akpc806a/Voltage_Logger/Firmware/IAR/README.md

This is project for IAR 6.50.3.4757 based on ChibiOS 2.6.7 RTOS for voltage logger
