akpc806a/Voltage_Logger/Tests/Temperature/Temperature.xlsx

Sheet: 00-00-07
Timestamp | ch #1 | ch #3 | ch #5 | ch #7 |  |  | Calculted temperature | Extech SDL200 | Error
8972 | 1.669652 | 1.148777 | 0.730923 | 0.832038 | Vref | 1.24 | 85.9304 | 85.8 | -0.1304
9972 | 1.667912 | 1.173341 | 0.743655 | 0.869477 | Gain | 0.005 | 85.5824 | 85.8 | 0.2176
10972 | 1.667856 | 1.192365 | 0.774777 | 0.906898 |  |  | 85.5712 | 85 | -0.5712
11972 | 1.667979 | 1.205415 | 0.789159 | 0.917454 |  |  | 85.5958 | 85 | -0.5958
12972 | 1.668414 | 1.215902 | 0.806305 | 0.935535 |  |  | 85.6828 | 85 | -0.6828
13972 | 1.667759 | 1.223687 | 0.818528 | 0.957894 |  |  | 85.5518 | 85 | -0.5518
14972 | 1.667035 | 1.229264 | 0.834112 | 0.979133 |  |  | 85.407 | 85 | -0.407
15972 | 1.666353 | 1.232514 | 0.854215 | 0.989091 |  |  | 85.2706 | 84.9 | -0.3706
16972 | 1.666536 | 1.235038 | 0.87494 | 0.988742 |  |  | 85.3072 | 84.9 | -0.4072
17972 | 1.66641 | 1.23622 | 0.877621 | 0.985095 |  |  | 85.282 | 84.8 | -0.482
18972 | 1.666479 | 1.237693 | 0.866878 | 0.980948 |  |  | 85.2958 | 84.7 | -0.5958
19972 | 1.666222 | 1.237985 | 0.860801 | 0.978258 |  |  | 85.2444 | 84.6 | -0.6444
20972 | 1.666234 | 1.238569 | 0.858324 | 0.976886 |  |  | 85.2468 | 84.6 | -0.6468
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
