akpc806a/Voltage_Logger/Tests/AC/XLS/50Hz.xls

Timestamp | ch #1 | ch #2 | ch #3 | ch #4 | ch #5 | ch #6
1249693 | 2.823217 | 2.823291 | 2.822742 | 2.815551 | 2.799818 | 2.768135 | 2.725456 | 2.675368 | 0
1249693 | 2.828029 | 2.823327 | 2.821532 | 2.820497 | 2.80821 | 2.785501 | 2.751491 | 2.723666 | 0
1249694 | 2.819208 | 2.824634 | 2.820223 | 2.820053 | 2.815592 | 2.802511 | 2.77843 | 2.747098 | 1
1249694 | 2.822416 | 2.823371 | 2.821441 | 2.821136 | 2.819011 | 2.810856 | 2.79458 | 2.771691 | 1
1249695 | 2.824019 | 2.822134 | 2.823909 | 2.821287 | 2.820044 | 2.814165 | 2.802276 | 2.788012 | 2
1249695 | 2.825623 | 2.82238 | 2.820185 | 2.821087 | 2.820086 | 2.818016 | 2.809836 | 2.795511 | 2
1249696 | 2.82001 | 2.821805 | 2.821068 | 2.821568 | 2.819959 | 2.819995 | 2.813159 | 2.803486 | 3
1249696 | 2.820812 | 2.822239 | 2.820561 | 2.820442 | 2.820106 | 2.820467 | 2.815516 | 2.809169 | 3
1249697 | 2.820812 | 2.818284 | 2.82151 | 2.822335 | 2.820624 | 2.820868 | 2.817389 | 2.81156 | 4
1249697 | 2.820812 | 2.82038 | 2.820765 | 2.821418 | 2.819721 | 2.820692 | 2.818974 | 2.814574 | 4
1249698 | 2.819208 | 2.817951 | 2.819907 | 2.821907 | 2.820787 | 2.820261 | 2.81902 | 2.815933 | 5
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
