akpc806a/Voltage_Logger/Tests/AC/XLS/50Hz_sine.xls

Timestamp | ch #1 | ch #2 | ch #3
130326 | 1.957188 | 1.900009 | 1.834909 | 1.772586 | 1.711889 | 1.654843 | 1.669148 | 1.617489 | 0
130326 | 2.162469 | 2.105605 | 2.042101 | 1.980809 | 1.920322 | 1.861985 | 1.805135 | 1.751734 | 0
130327 | 2.284355 | 2.229644 | 2.172766 | 2.17375 | 2.115637 | 2.057524 | 2.001172 | 1.946627 | 1
130327 | 2.446334 | 2.402208 | 2.350606 | 2.292805 | 2.23642 | 2.179936 | 2.182333 | 2.127653 | 1
130328 | 2.589871 | 2.548571 | 2.502257 | 2.451353 | 2.400237 | 2.347183 | 2.29255 | 2.23928 | 2
130328 | 2.660436 | 2.626857 | 2.58568 | 2.581889 | 2.536939 | 2.488673 | 2.438985 | 2.38816 | 2
130329 | 2.739822 | 2.716279 | 2.684053 | 2.64893 | 2.609881 | 2.566282 | 2.555363 | 2.51023 | 3
130329 | 2.77751 | 2.77126 | 2.748572 | 2.720985 | 2.690234 | 2.655717 | 2.61574 | 2.573851 | 3
130330 | 2.785529 | 2.781561 | 2.769282 | 2.75528 | 2.733601 | 2.707433 | 2.676489 | 2.640907 | 4
130330 | 2.75586 | 2.768193 | 2.765361 | 2.755483 | 2.741133 | 2.721361 | 2.701709 | 2.673696 | 4
130331 | 2.697322 | 2.712897 | 2.724253 | 2.727071 | 2.723109 | 2.712719 | 2.697927 | 2.675187 | 5
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
