akpc806a/Voltage_Logger/Tests/AC/XLS/5Hz.xls

Timestamp | ch #1 | ch #2 | ch #3 | ch #4 | ch #5 | ch #6
1895700 | 2.807982 | 2.804748 | 2.80306 | 2.805846 | 2.805466 | 2.805039 | 2.805048 | 2.805909 | 0
1895701 | 2.811189 | 2.807578 | 2.80391 | 2.803735 | 2.805328 | 2.805448 | 2.806088 | 2.80543 | 1
1895701 | 2.807982 | 2.805927 | 2.804815 | 2.804624 | 2.806803 | 2.80542 | 2.806027 | 2.806239 | 1
1895702 | 2.809585 | 2.804661 | 2.806663 | 2.804138 | 2.806458 | 2.805902 | 2.804701 | 2.805554 | 2
1895702 | 2.800765 | 2.806163 | 2.808363 | 2.806937 | 2.806855 | 2.806181 | 2.804655 | 2.80502 | 2
1895703 | 2.805576 | 2.803645 | 2.808332 | 2.806864 | 2.805705 | 2.804849 | 2.805269 | 2.805009 | 3
1895703 | 2.804774 | 2.800683 | 2.808138 | 2.805348 | 2.805883 | 2.805293 | 2.805477 | 2.804747 | 3
1895704 | 2.805576 | 2.807069 | 2.805771 | 2.805568 | 2.805592 | 2.805379 | 2.805028 | 2.804716 | 4
1895704 | 2.800765 | 2.805562 | 2.805367 | 2.805284 | 2.80561 | 2.805596 | 2.80539 | 2.804558 | 4
1895705 | 2.800765 | 2.803367 | 2.806285 | 2.806414 | 2.805213 | 2.805394 | 2.805094 | 2.805112 | 5
1895705 | 2.804774 | 2.807104 | 2.805043 | 2.806707 | 2.80439 | 2.806185 | 2.804813 | 2.805058 | 5
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
