akpc806a/Voltage_Logger/Tests/AC/Raw/5Hz.csv

Timestamp | ch #1 | ch #2 | ch #3 | ch #4 | ch #5 | ch #6
1895700 | 2.807982 | 2.804748 | 2.803060 | 2.805846 | 2.805466 | 2.805039 | 2.805048 | 2.805909
1895701 | 2.811189 | 2.807578 | 2.803910 | 2.803735 | 2.805328 | 2.805448 | 2.806088 | 2.805430
1895701 | 2.807982 | 2.805927 | 2.804815 | 2.804624 | 2.806803 | 2.805420 | 2.806027 | 2.806239
1895702 | 2.809585 | 2.804661 | 2.806663 | 2.804138 | 2.806458 | 2.805902 | 2.804701 | 2.805554
1895702 | 2.800765 | 2.806163 | 2.808363 | 2.806937 | 2.806855 | 2.806181 | 2.804655 | 2.805020
1895703 | 2.805576 | 2.803645 | 2.808332 | 2.806864 | 2.805705 | 2.804849 | 2.805269 | 2.805009
1895703 | 2.804774 | 2.800683 | 2.808138 | 2.805348 | 2.805883 | 2.805293 | 2.805477 | 2.804747
1895704 | 2.805576 | 2.807069 | 2.805771 | 2.805568 | 2.805592 | 2.805379 | 2.805028 | 2.804716
1895704 | 2.800765 | 2.805562 | 2.805367 | 2.805284 | 2.805610 | 2.805596 | 2.805390 | 2.804558
1895705 | 2.800765 | 2.803367 | 2.806285 | 2.806414 | 2.805213 | 2.805394 | 2.805094 | 2.805112
1895705 | 2.804774 | 2.807104 | 2.805043 | 2.806707 | 2.804390 | 2.806185 | 2.804813 | 2.805058
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
