akpc806a/Voltage_Logger/Tests/AC/Raw/5Hz_sine.csv

Timestamp | ch #1 | ch #2 | ch #3 | ch #4
2362145 | 0.672578 | 0.676643 | 0.681734 | 0.680773 | 0.685947 | 0.690909 | 0.695176 | 0.699674
2362145 | 0.658946 | 0.663664 | 0.667896 | 0.671174 | 0.676548 | 0.681165 | 0.678435 | 0.683918
2362146 | 0.639701 | 0.646606 | 0.650312 | 0.655159 | 0.658547 | 0.664309 | 0.668011 | 0.673329
2362146 | 0.630079 | 0.635413 | 0.639606 | 0.639056 | 0.644443 | 0.649520 | 0.652765 | 0.657985
2362147 | 0.620456 | 0.623729 | 0.625893 | 0.628914 | 0.634332 | 0.639214 | 0.637651 | 0.642509
2362147 | 0.602013 | 0.603625 | 0.608435 | 0.613525 | 0.618445 | 0.623552 | 0.627754 | 0.632579
2362148 | 0.591588 | 0.594798 | 0.598987 | 0.599502 | 0.603222 | 0.608018 | 0.612790 | 0.615691
2362148 | 0.574749 | 0.581866 | 0.584336 | 0.590226 | 0.592972 | 0.597719 | 0.597370 | 0.600965
2362149 | 0.562721 | 0.566617 | 0.570195 | 0.572746 | 0.578357 | 0.583357 | 0.587048 | 0.591738
2362149 | 0.553098 | 0.557280 | 0.559717 | 0.559270 | 0.563811 | 0.568244 | 0.573056 | 0.577277
2362150 | 0.540268 | 0.544500 | 0.546268 | 0.550606 | 0.554566 | 0.559785 | 0.559247 | 0.563508
2362150 | 0.526636 | 0.530373 | 0.533938 | 0.536911 | 0.540789 | 0.546733 | 0.550006 | 0.554264
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
