akpc806a/Voltage_Logger/Tests/AC/XLS/5Hz.png

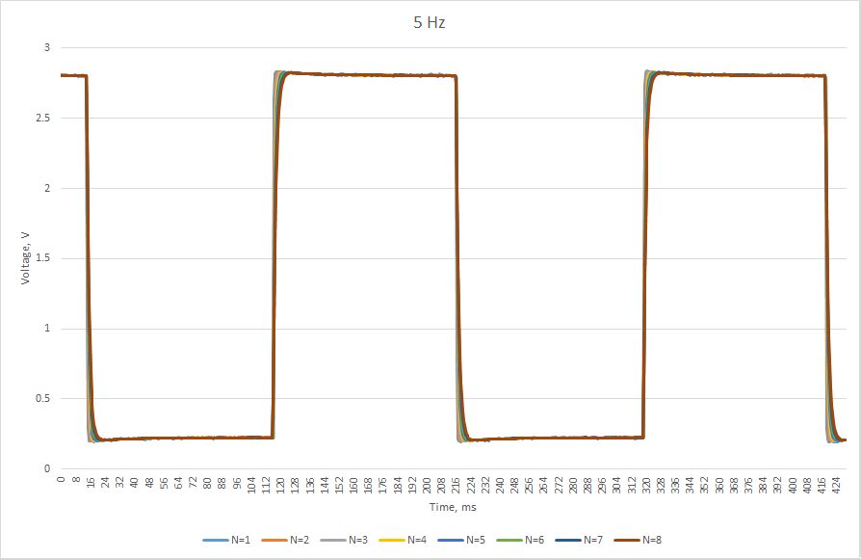
Tests/AC/XLS/5Hz.png
