akpc806a/Voltage_Logger/Tests/AC/XLS/5Hz_sine.png

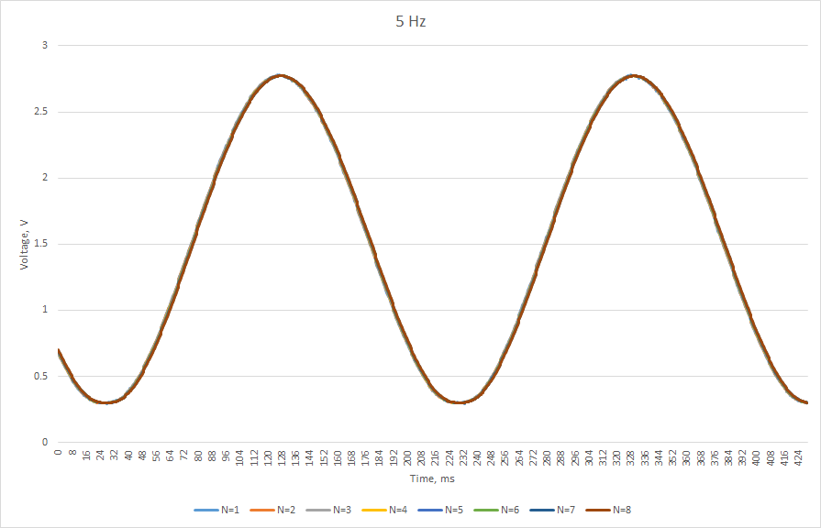
Tests/AC/XLS/5Hz_sine.png
