akpc806a/Voltage_Logger/Tests/AC/XLS/50Hz.png

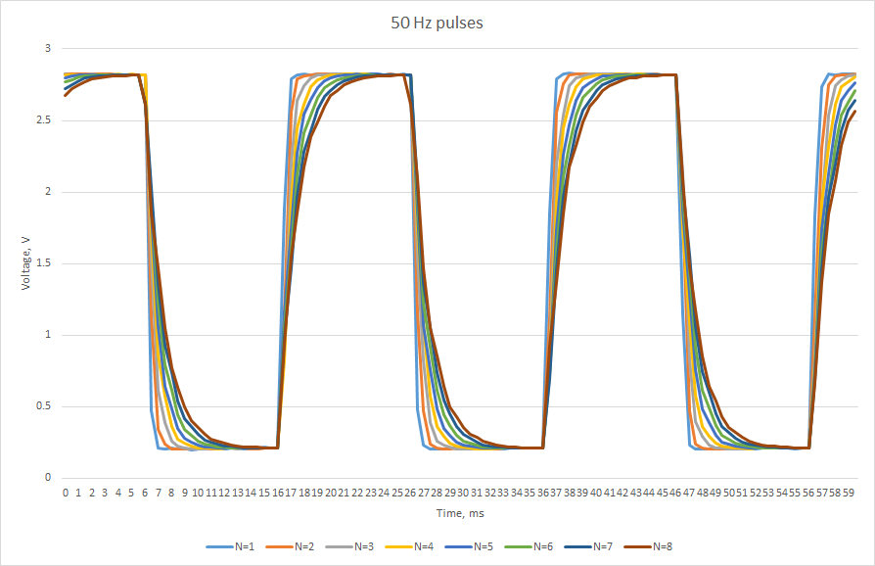
Tests/AC/XLS/50Hz.png
