akpc806a/Voltage_Logger/Tests/AC/XLS/50Hz_sine.png

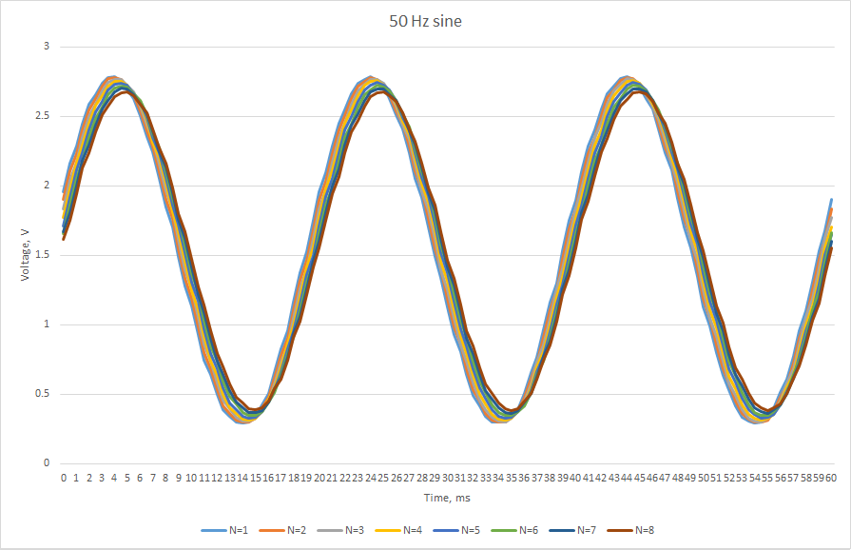
Tests/AC/XLS/50Hz_sine.png
