akpc806a/Voltage_Logger/Hardware/Voltage_Logger.pdf

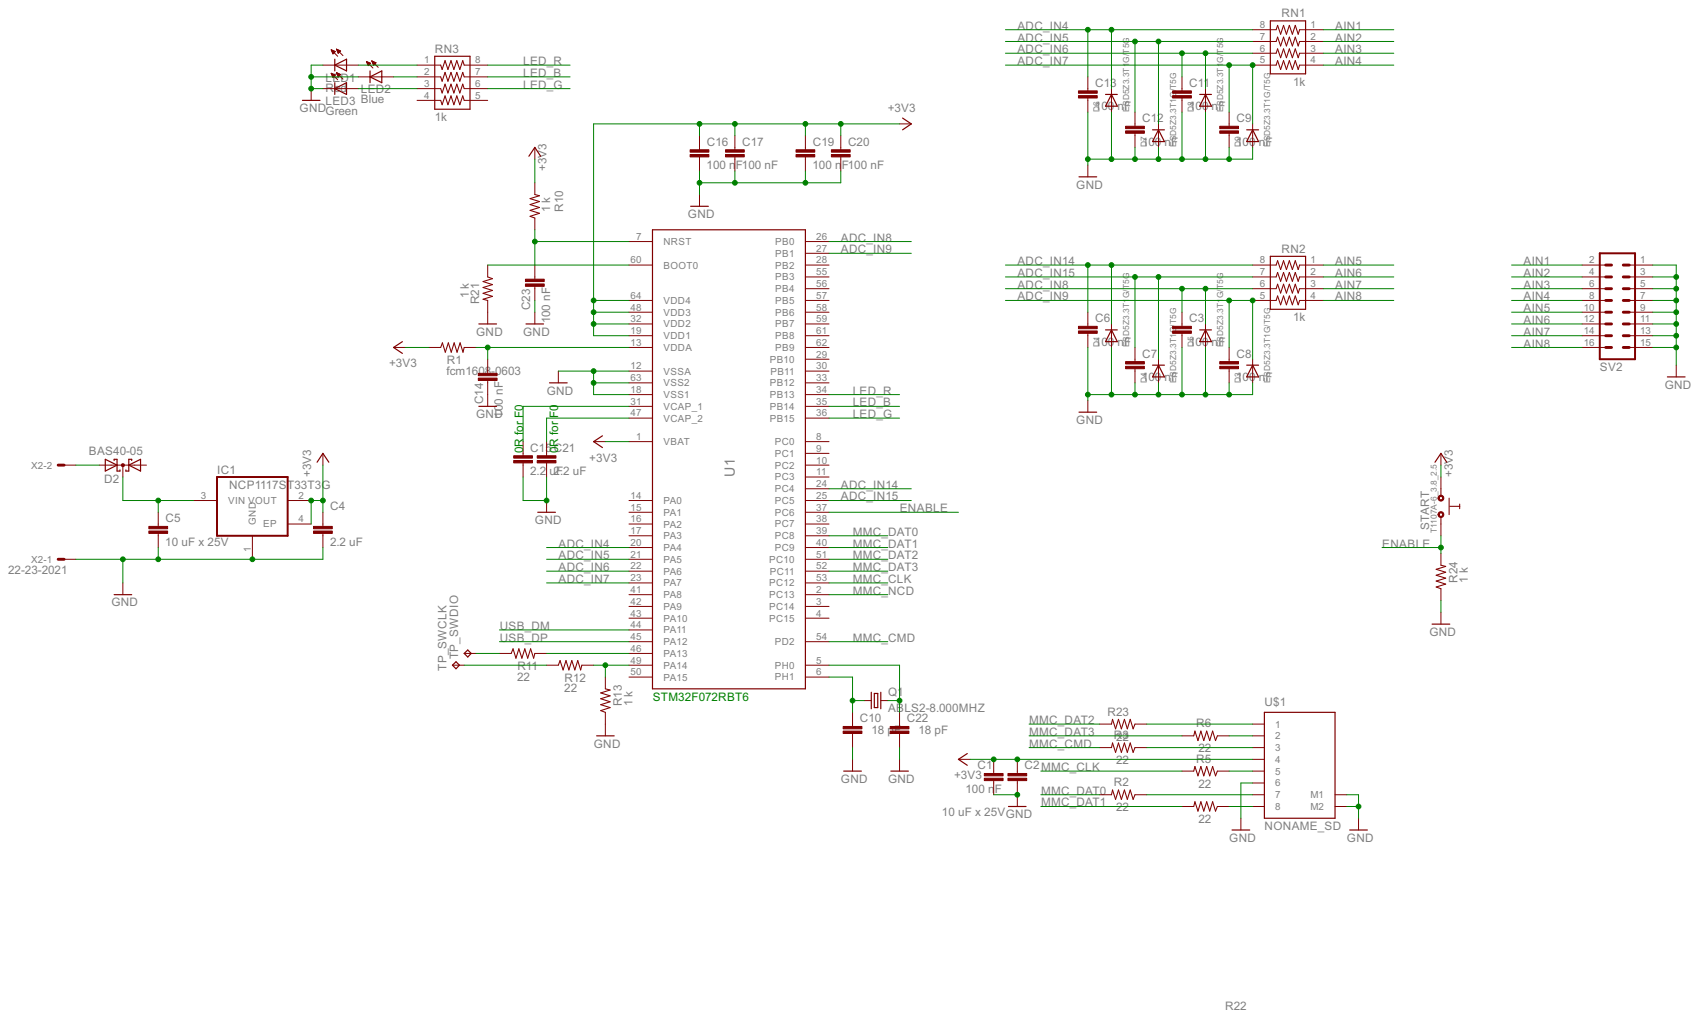
[picture p7: page 1]
