akpc806a/Voltage_Logger/Hardware/Voltage_Logger.brd

## EAGLE design Hardware/Voltage_Logger.brd (2017-04-07)

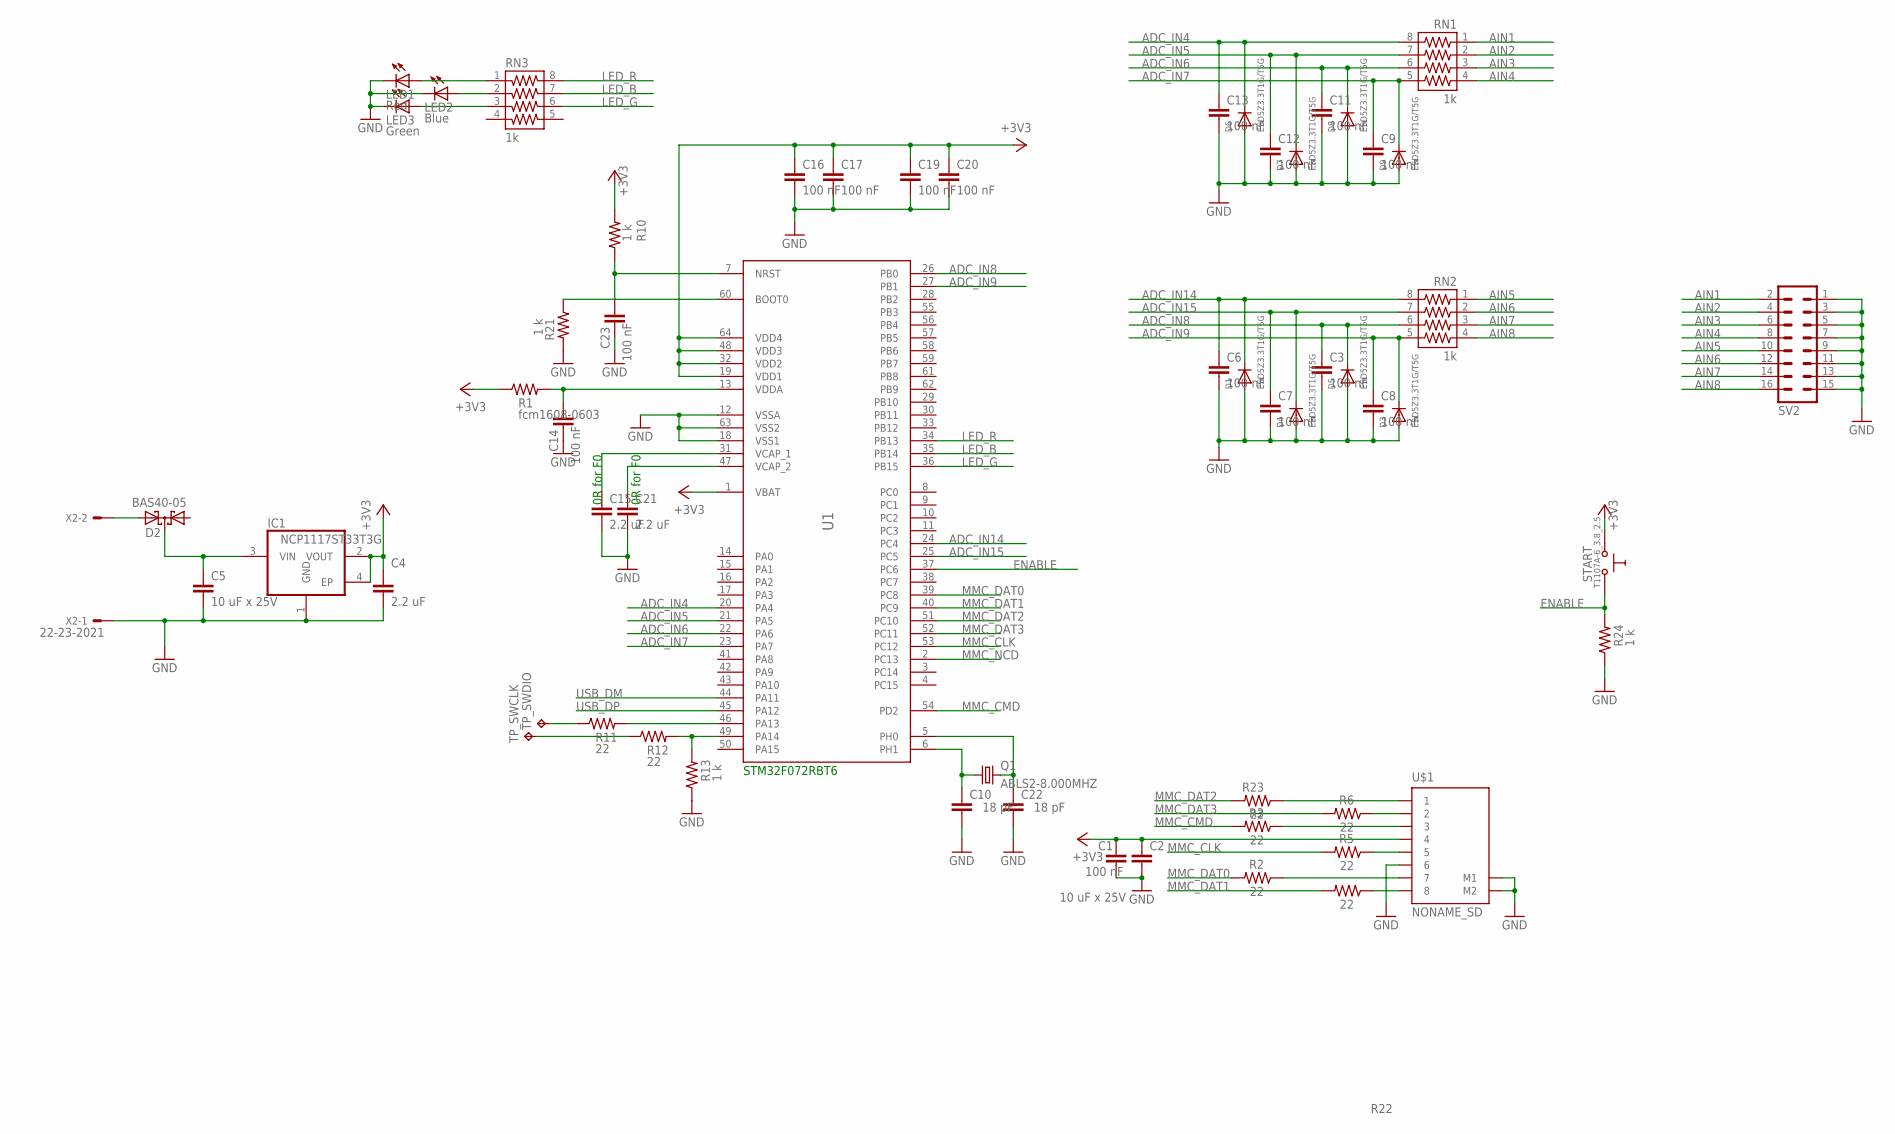
[picture p8: schematic Voltage_Logger.sch]

Parts:
C1, C3, C6, C7, C8, C9, C11, C12, C13, C14, C16, C17, C19, C20, C23: 100 nF; C0603
C2, C5: 10 uF x 25V; C1206
C4, C15, C21: 2.2 uF; C0603
C10, C22: 18 pF; C0603
D1, D3, D4, D5, D6, D7, D8, D9: ESD5Z3.3T1G/T5G; SOD-523
D2: BAS40-05; SOT23
IC1: NCP1117ST33T3G; SOT223
LED1: Red; LED_SML0603
LED2: Blue; LED_SML0603
LED3: Green; LED_SML0603
Q1: ABLS2-8.000MHZ; SM49
R1: fcm1608-0603; R0603
R2, R3, R5, R6, R11, R12, R22, R23: 22; R0603
R10, R13, R21, R24: 1 k; R0603
RN1, RN2, RN3: 1k; 742-8NS
START: T1107A-6_3.8_2.5; SW-TAKT_6X3.5_SMD
SV2: MA08-2
TP_SWCLK: TPTP10SQ; TP10SQ
TP_SWDIO: TPTP10SQ; TP10SQ
U1: STM32F405RGT6; LQFP64
U$1: NONAME_SD
X2: 22-23-2021

Connections:
+3V3: C1.1, C2.1, C4.1, C16.1, C17.1, C19.1, C20.1, IC1.2 (VOUT), IC1.4 (EP), R1.1, R10.2, START.P$1 (0), U1.1 (VBAT), U1.19 (VDD1), U1.32 (VDD2), U1.48 (VDD3), U1.64 (VDD4), U$1.4
ADC_IN4: C13.1, D6.K (C), RN1.8, U1.20 (PA4)
ADC_IN5: C12.1, D7.K (C), RN1.7, U1.21 (PA5)
ADC_IN6: C11.1, D8.K (C), RN1.6, U1.22 (PA6)
ADC_IN7: C9.1, D9.K (C), RN1.5, U1.23 (PA7)
ADC_IN8: C3.1, D5.K (C), RN2.6, U1.26 (PB0)
ADC_IN9: C8.1, D3.K (C), RN2.5, U1.27 (PB1)
ADC_IN14: C6.1, D1.K (C), RN2.8, U1.24 (PC4)
ADC_IN15: C7.1, D4.K (C), RN2.7, U1.25 (PC5)
AIN1: RN1.1, SV2.2
AIN2: RN1.2, SV2.4
AIN3: RN1.3, SV2.6
AIN4: RN1.4, SV2.8
AIN5: RN2.1, SV2.10
AIN6: RN2.2, SV2.12
AIN7: RN2.3, SV2.14
AIN8: RN2.4, SV2.16
ENABLE: R24.2, START.P$2 (1), U1.37 (PC6)
GND: C1.2, C2.2, C3.2, C4.2, C5.2, C6.2, C7.2, C8.2, C9.2, C10.2, C11.2, C12.2, C13.2, C14.2, C15.2, C16.2, C17.2, C19.2, C20.2, C21.2, C22.2, C23.2, D1.A, D3.A, D4.A, D5.A, D6.A, D7.A, D8.A, D9.A, IC1.1 (GND), LED1.C, LED2.C, LED3.C, R13.1, R21.2, R24.1, SV2.1, SV2.3, SV2.5, SV2.7, SV2.9, SV2.11, SV2.13, SV2.15, U1.12 (VSSA), U1.18 (VSS1), U1.63 (VSS2), U$1.6, U$1.M1, U$1.M2, X2.1
LED_B: RN3.7, U1.35 (PB14)
LED_G: RN3.6, U1.36 (PB15)
LED_R: RN3.8, U1.34 (PB13)
MMC_CLK: R5.2, U1.53 (PC12)
MMC_CMD: R3.2, U1.54 (PD2)
MMC_DAT0: R2.2, U1.39 (PC8)
MMC_DAT1: R22.2, U1.40 (PC9)
MMC_DAT2: R23.2, U1.51 (PC10)
MMC_DAT3: R6.2, U1.52 (PC11)
MMC_NCD: U1.2 (PC13)
unnamed: C15.1, U1.31 (VCAP_1)
unnamed: D2.2 (A2), X2.2
unnamed: C14.1, R1.2, U1.13 (VDDA)
unnamed: R3.1, U$1.3
unnamed: R2.1, U$1.7
unnamed: R5.1, U$1.5
unnamed: LED2.A, RN3.2
unnamed: C5.1, D2.3 (C), IC1.3 (VIN)
unnamed: R6.1, U$1.2
unnamed: LED1.A, RN3.1
unnamed: LED3.A, RN3.3
unnamed: R22.1, U$1.8
unnamed: R23.1, U$1.1
unnamed: R11.2, U1.46 (PA13)
unnamed: R12.2, R13.2, U1.49 (PA14)
unnamed: C21.1, U1.47 (VCAP_2)
unnamed: R11.1, TP_SWDIO.TP
unnamed: R12.1, TP_SWCLK.TP
unnamed: C23.1, R10.1, U1.7 (NRST)
unnamed: R21.1, U1.60 (BOOT0)
unnamed: C22.1, Q1.2, U1.5 (PH0)
unnamed: C10.1, Q1.1, U1.6 (PH1)
USB_DM: U1.44 (PA11)
USB_DP: U1.45 (PA12)

Notes on the sheet:
STM32F072RBT6
0R for F0

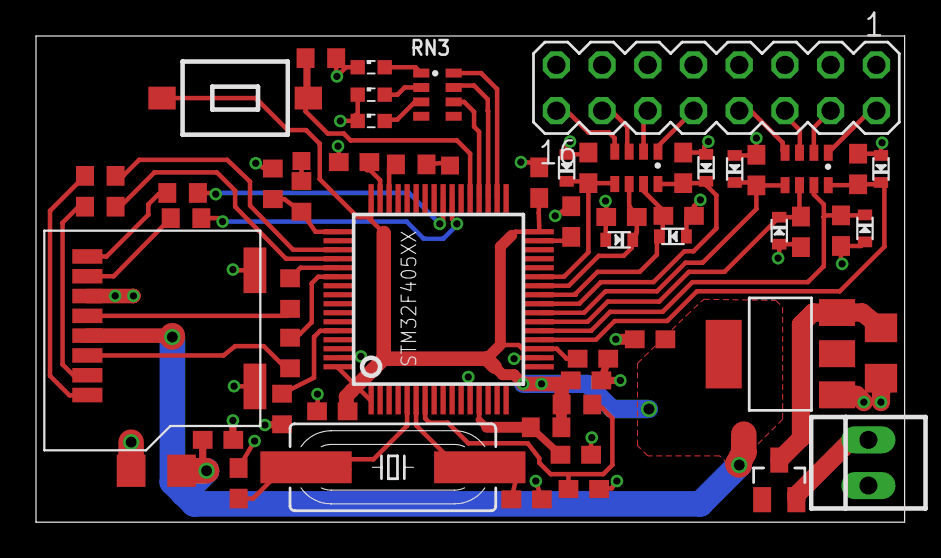
[picture p9: board Voltage_Logger.brd from above]

Board: 2 copper layers, 48.3 x 27.0 mm, 59 parts (0 on the bottom side), 50 nets.
