akpc806a/Voltage_Logger/Firmware/IAR/boards/ST_STM32F4_DISCOVERY/board.h

/*
    ChibiOS/RT - Copyright (C) 2006,2007,2008,2009,2010,
                 2011,2012 Giovanni Di Sirio.

    This file is part of ChibiOS/RT.

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
    You should have received a copy of the GNU General Public License
    along with this program.  If not, see <http://www.gnu.org/licenses/>.
*/

#ifndef _BOARD_H_
#define _BOARD_H_

/*
 * Setup for STMicroelectronics STM32F4-Discovery board.
 */

/*
 * Board identifier.
 */
#define BOARD_ST_STM32F4_DISCOVERY
#define BOARD_NAME                  "STMicroelectronics STM32F4-Discovery"


/*
 * Board oscillators-related settings.
 * NOTE: LSE not fitted.
 */
#if !defined(STM32_LSECLK)
#define STM32_LSECLK                32768
#endif

#if !defined(STM32_HSECLK)
#define STM32_HSECLK                8000000
#endif

/*
 * Ethernet PHY type.
 */
//#define BOARD_PHY_ID            MII_DP83848I_ID
#define BOARD_PHY_ID            0x0007C0F0  // LAN8720 ID code

#define BOARD_PHY_RMII

/*******************************************************************
 * CONNECTION LAYOUT BETWEEN ETH PHY DP83848 AND STM32F4DISCOVERY  *
 *******************************************************************
 *
 * PC1----------------MDC
 * PA2----------------MDIO
 * PA1----------------OSCIN
 * PA7----------------CRS
 * PC4----------------RX0
 * PC5----------------RX1
 * PB11---------------TX_EN
 * PB12---------------TX0
 * PB13---------------TX1
 *
 *
 */



/*
 * Board voltages.
 * Required for performance limits calculation.
 */
#define STM32_VDD                   300

/*
 * MCU type as defined in the ST header file stm32f4xx.h.
 */
#define STM32F40_41xxx

/*
 * IO pins assignments.
 */
#define GPIOA_PIN0                0
#define GPIOA_PIN1_ETH_OSCIN        1 // ETH OSCIN
#define GPIOA_PIN2         2 // ETH MDIO
#define GPIOA_PIN3                  3
#define GPIOA_PIN4                  4
#define GPIOA_PIN5                  5
#define GPIOA_PIN6                  6
#define GPIOA_PIN7          7 // ETH CRS
#define GPIOA_PIN8                  8
#define GPIOA_PIN_9              	 9
#define GPIOA_PIN_10             	 10
#define GPIOA_PIN11_CAN1_RX       		     11
#define GPIOA_PIN12_CAN1_TX       		     12
#define GPIOA_SWDIO                 13
#define GPIOA_SWCLK                 14
#define GPIOA_PIN15                 15

#define GPIOB_PIN0                  0
#define GPIOB_PIN1                  1
#define GPIOB_PIN2                  2
#define GPIOB_SWO                   3
#define GPIOB_PIN4                  4
#define GPIOB_PIN5                  5
#define GPIOB_PIN6_USART1_TX                   6
#define GPIOB_PIN7_USART1_RX                  7
#define GPIOB_PIN8                  8
#define GPIOB_SDA                   9
#define GPIOB_CLK_IN                10
#define GPIOB_PIN11_ETH_TX_EN       11 // ETH TX EN
#define GPIOB_PIN12_CAN2_RX         12 // ETH TX0
#define GPIOB_PIN13_LED_R         13 // ETH TX1
#define GPIOB_PIN14_LED_B                 14
#define GPIOB_PIN15_LED_G                 15

#define GPIOC_OTG_FS_POWER_ON       0
#define GPIOC_PIN1_MDC              1 // ETH MDC
#define GPIOC_PIN2                  2
#define GPIOC_PDM_OUT               3
#define GPIOC_PIN4 			 4 // ETH RX0
#define GPIOC_PIN5          5 // ETH RX1
#define GPIOC_PIN6_BTN                  6
#define GPIOC_PIN7_USART6_RX                  7
#define GPIOC_PIN8_SDIO_DAT0                  8
#define GPIOC_PIN9_SDIO_DAT1                  9
#define GPIOC_PIN10_SDIO_DAT2              10
#define GPIOC_PIN11_SDIO_DAT3              11
#define GPIOC_PIN12_SDIO_CLK                  12
#define GPIOC_PIN13                 13
#define GPIOC_PIN14                 14
#define GPIOC_PIN15                 15

#define GPIOD_PIN0                  0
#define GPIOD_PIN1                  1
#define GPIOD_PIN2_SDIO_CMD                  2
#define GPIOD_PIN3                  3
#define GPIOD_RESET                 4
#define GPIOD_PIN5_USART2_TX          5
#define GPIOD_PIN6_USART2_RX                  6
#define GPIOD_PIN7                  7
#define GPIOD_PIN8                  8
#define GPIOD_PIN9_USART3_RX                  9
#define GPIOD_PIN10                 10
#define GPIOD_PIN11                 11
#define GPIOD_PIN12        12
#define GPIOD_PIN13      13
#define GPIOD_PIN14         14
#define GPIOD_PIN15        15

#define GPIOE_INT1                  0
#define GPIOE_INT2                  1
#define GPIOE_PIN2                  2
#define GPIOE_CS_SPI                3
#define GPIOE_PIN4                  4
#define GPIOE_PIN5                  5
#define GPIOE_PIN6                  6
#define GPIOE_PIN7                  7
#define GPIOE_PIN8                  8
#define GPIOE_PIN9                  9
#define GPIOE_PIN10                 10
#define GPIOE_PIN11                 11
#define GPIOE_PIN12                 12
#define GPIOE_PIN13                 13
#define GPIOE_PIN14                 14
#define GPIOE_PIN15                 15

#define GPIOF_PIN0                  0
#define GPIOF_PIN1                  1
#define GPIOF_PIN2                  2
#define GPIOF_PIN3                  3
#define GPIOF_PIN4                  4
#define GPIOF_PIN5                  5
#define GPIOF_PIN6                  6
#define GPIOF_PIN7                  7
#define GPIOF_PIN8                  8
#define GPIOF_PIN9                  9
#define GPIOF_PIN10                 10
#define GPIOF_PIN11                 11
#define GPIOF_PIN12                 12
#define GPIOF_PIN13                 13
#define GPIOF_PIN14                 14
#define GPIOF_PIN15                 15

#define GPIOG_PIN0                  0
#define GPIOG_PIN1                  1
#define GPIOG_PIN2                  2
#define GPIOG_PIN3                  3
#define GPIOG_PIN4                  4
#define GPIOG_PIN5                  5
#define GPIOG_PIN6                  6
#define GPIOG_PIN7                  7
#define GPIOG_PIN8                  8
#define GPIOG_PIN9                  9
#define GPIOG_PIN10                 10
#define GPIOG_PIN11                 11
#define GPIOG_PIN12                 12
#define GPIOG_PIN13                 13
#define GPIOG_PIN14                 14
#define GPIOG_PIN15                 15

#define GPIOH_OSC_IN                0
#define GPIOH_OSC_OUT               1
#define GPIOH_PIN2                  2
#define GPIOH_PIN3                  3
#define GPIOH_PIN4                  4
#define GPIOH_PIN5                  5
#define GPIOH_PIN6                  6
#define GPIOH_PIN7                  7
#define GPIOH_PIN8                  8
#define GPIOH_PIN9                  9
#define GPIOH_PIN10                 10
#define GPIOH_PIN11                 11
#define GPIOH_PIN12                 12
#define GPIOH_PIN13                 13
#define GPIOH_PIN14                 14
#define GPIOH_PIN15                 15

#define GPIOI_PIN0                  0
#define GPIOI_PIN1                  1
#define GPIOI_PIN2                  2
#define GPIOI_PIN3                  3
#define GPIOI_PIN4                  4
#define GPIOI_PIN5                  5
#define GPIOI_PIN6                  6
#define GPIOI_PIN7                  7
#define GPIOI_PIN8                  8
#define GPIOI_PIN9                  9
#define GPIOI_PIN10                 10
#define GPIOI_PIN11                 11
#define GPIOI_PIN12                 12
#define GPIOI_PIN13                 13
#define GPIOI_PIN14                 14
#define GPIOI_PIN15                 15

/*
 * I/O ports initial setup, this configuration is established soon after reset
 * in the initialization code.
 * Please refer to the STM32 Reference Manual for details.
 */
#define PIN_MODE_INPUT(n)           (0U << ((n) * 2))
#define PIN_MODE_OUTPUT(n)          (1U << ((n) * 2))
#define PIN_MODE_ALTERNATE(n)       (2U << ((n) * 2))
#define PIN_MODE_ANALOG(n)          (3U << ((n) * 2))
#define PIN_ODR_LOW(n)              (0U << (n))
#define PIN_ODR_HIGH(n)             (1U << (n))
#define PIN_OTYPE_PUSHPULL(n)       (0U << (n))
#define PIN_OTYPE_OPENDRAIN(n)      (1U << (n))
#define PIN_OSPEED_2M(n)            (0U << ((n) * 2))
#define PIN_OSPEED_25M(n)           (1U << ((n) * 2))
#define PIN_OSPEED_50M(n)           (2U << ((n) * 2))
#define PIN_OSPEED_100M(n)          (3U << ((n) * 2))
#define PIN_PUPDR_FLOATING(n)       (0U << ((n) * 2))
#define PIN_PUPDR_PULLUP(n)         (1U << ((n) * 2))
#define PIN_PUPDR_PULLDOWN(n)       (2U << ((n) * 2))
#define PIN_AFIO_AF(n, v)           ((v##U) << ((n % 8) * 4))

/*
 * GPIOA setup:
 *
 * PA0  - BUTTON                    (input floating).
 * PA1  - PIN1                      (input pullup).
 * PA2  - PIN2                      (input pullup).
 * PA3  - PIN3                      (input pullup).
 * PA4  - LRCK                      (alternate 6).
 * PA5  - SPC                       (alternate 5).
 * PA6  - SDO                       (alternate 5).
 * PA7  - SDI                       (alternate 11).
 * PA8  - PIN8                      (input pullup).
 * PA9  - PIN9               		(input pullup).
 * PA10 - PIN10                		(input pullup).
 * PA11 - PA11      	            (input pullup)
 * PA12 - PA12          	        (input pullup)
 * PA13 - SWDIO                     (alternate 0).
 * PA14 - SWCLK                     (alternate 0).
 * PA15 - PIN15                     (input pullup).
 */
#define VAL_GPIOA_MODER             (PIN_MODE_INPUT(GPIOA_PIN0) |         \
                                     PIN_MODE_INPUT(GPIOA_PIN1_ETH_OSCIN) |           \
                                     PIN_MODE_INPUT(GPIOA_PIN2) |           \
                                     PIN_MODE_INPUT(GPIOA_PIN3) |           \
                                     PIN_MODE_ANALOG(GPIOA_PIN4) |       \
                                     PIN_MODE_ANALOG(GPIOA_PIN5) |        \
                                     PIN_MODE_ANALOG(GPIOA_PIN6) |        \
                                     PIN_MODE_ANALOG(GPIOA_PIN7) |        \
                                     PIN_MODE_INPUT(GPIOA_PIN8) |           \
                                     PIN_MODE_INPUT(GPIOA_PIN_9) |        \
                                     PIN_MODE_INPUT(GPIOA_PIN_10) |  \
                                     PIN_MODE_INPUT(GPIOA_PIN11_CAN1_RX) |  \
                                     PIN_MODE_INPUT(GPIOA_PIN12_CAN1_TX) |  \
                                     PIN_MODE_ALTERNATE(GPIOA_SWDIO) |      \
                                     PIN_MODE_ALTERNATE(GPIOA_SWCLK) |      \
                                     PIN_MODE_INPUT(GPIOA_PIN15))
#define VAL_GPIOA_OTYPER            (PIN_OTYPE_PUSHPULL(GPIOA_PIN0) |     \
                                     PIN_OTYPE_PUSHPULL(GPIOA_PIN1_ETH_OSCIN) |       \
                                     PIN_OTYPE_PUSHPULL(GPIOA_PIN2) |       \
                                     PIN_OTYPE_PUSHPULL(GPIOA_PIN3) |       \
                                     PIN_OTYPE_PUSHPULL(GPIOA_PIN4) |       \
                                     PIN_OTYPE_PUSHPULL(GPIOA_PIN5) |        \
                                     PIN_OTYPE_PUSHPULL(GPIOA_PIN6) |        \
                                     PIN_OTYPE_PUSHPULL(GPIOA_PIN7) |        \
                                     PIN_OTYPE_PUSHPULL(GPIOA_PIN8) |       \
                                     PIN_OTYPE_PUSHPULL(GPIOA_PIN_9) |    \
                                     PIN_OTYPE_PUSHPULL(GPIOA_PIN_10) |  \
                                     PIN_OTYPE_PUSHPULL(GPIOA_PIN11_CAN1_RX) |  \
                                     PIN_OTYPE_PUSHPULL(GPIOA_PIN12_CAN1_TX) |  \
                                     PIN_OTYPE_PUSHPULL(GPIOA_SWDIO) |      \
                                     PIN_OTYPE_PUSHPULL(GPIOA_SWCLK) |      \
                                     PIN_OTYPE_PUSHPULL(GPIOA_PIN15))
#define VAL_GPIOA_OSPEEDR   0xFFFFFFFF
#define VAL_GPIOA_PUPDR             (PIN_PUPDR_FLOATING(GPIOA_PIN0) |     \
                                     PIN_PUPDR_PULLUP(GPIOA_PIN1_ETH_OSCIN) |         \
                                     PIN_PUPDR_PULLDOWN(GPIOA_PIN2) |         \
                                     PIN_PUPDR_PULLUP(GPIOA_PIN3) |         \
                                     PIN_PUPDR_FLOATING(GPIOA_PIN4) |       \
                                     PIN_PUPDR_FLOATING(GPIOA_PIN5) |        \
                                     PIN_PUPDR_FLOATING(GPIOA_PIN6) |        \
                                     PIN_PUPDR_FLOATING(GPIOA_PIN7) |        \
                                     PIN_PUPDR_PULLUP(GPIOA_PIN8) |         \
                                     PIN_PUPDR_FLOATING(GPIOA_PIN_9) |    \
                                     PIN_PUPDR_FLOATING(GPIOA_PIN_10) |  \
                                     PIN_PUPDR_FLOATING(GPIOA_PIN11_CAN1_RX) |  \
                                     PIN_PUPDR_FLOATING(GPIOA_PIN12_CAN1_TX) |  \
                                     PIN_PUPDR_FLOATING(GPIOA_SWDIO) |      \
                                     PIN_PUPDR_FLOATING(GPIOA_SWCLK) |      \
                                     PIN_PUPDR_PULLUP(GPIOA_PIN15))
#define VAL_GPIOA_ODR               (PIN_ODR_HIGH(GPIOA_PIN0) |           \
                                     PIN_ODR_HIGH(GPIOA_PIN1_ETH_OSCIN) |             \
                                     PIN_ODR_HIGH(GPIOA_PIN2) |             \
                                     PIN_ODR_HIGH(GPIOA_PIN3) |             \
                                     PIN_ODR_HIGH(GPIOA_PIN4) |             \
                                     PIN_ODR_LOW(GPIOA_PIN5) |              \
                                     PIN_ODR_LOW(GPIOA_PIN6) |              \
                                     PIN_ODR_LOW(GPIOA_PIN7) |              \
                                     PIN_ODR_HIGH(GPIOA_PIN8) |             \
                                     PIN_ODR_HIGH(GPIOA_PIN_9) |          \
                                     PIN_ODR_HIGH(GPIOA_PIN_10) |        \
                                     PIN_ODR_HIGH(GPIOA_PIN11_CAN1_RX) |        \
                                     PIN_ODR_HIGH(GPIOA_PIN12_CAN1_TX) |        \
                                     PIN_ODR_HIGH(GPIOA_SWDIO) |            \
                                     PIN_ODR_HIGH(GPIOA_SWCLK) |            \
                                     PIN_ODR_HIGH(GPIOA_PIN15))
#define VAL_GPIOA_AFRL              (PIN_AFIO_AF(GPIOA_PIN0, 0) |         \
                                     PIN_AFIO_AF(GPIOA_PIN1_ETH_OSCIN, 11) |           \
                                     PIN_AFIO_AF(GPIOA_PIN2, 11) |           \
                                     PIN_AFIO_AF(GPIOA_PIN3, 0) |           \
                                     PIN_AFIO_AF(GPIOA_PIN4, 6) |           \
                                     PIN_AFIO_AF(GPIOA_PIN5, 5) |            \
                                     PIN_AFIO_AF(GPIOA_PIN6, 5) |            \
                                     PIN_AFIO_AF(GPIOA_PIN7, 11))
#define VAL_GPIOA_AFRH              (PIN_AFIO_AF(GPIOA_PIN8, 0) |           \
                                     PIN_AFIO_AF(GPIOA_PIN_9, 0) |        \
                                     PIN_AFIO_AF(GPIOA_PIN_10, 0) |     \
                                     PIN_AFIO_AF(GPIOA_PIN11_CAN1_RX, 9) |     \
                                     PIN_AFIO_AF(GPIOA_PIN12_CAN1_TX, 9) |     \
                                     PIN_AFIO_AF(GPIOA_SWDIO, 0) |          \
                                     PIN_AFIO_AF(GPIOA_SWCLK, 0) |          \
                                     PIN_AFIO_AF(GPIOA_PIN15, 0))

/*
 * GPIOB setup:
 *
 * PB0  - PIN0                      (input pullup).
 * PB1  - PIN1                      (input pullup).
 * PB2  - PIN2                      (input pullup).
 * PB3  - SWO                       (alternate 0).
 * PB4  - PIN4                      (input pullup).
 * PB5  - PIN5                      (input pullup).
 * PB6  - SCL                       (alternate 4).
 * PB7  - PIN7                      (input pullup).
 * PB8  - PIN8                      (input pullup).
 * PB9  - SDA                       (alternate 4).
 * PB10 - CLK_IN                    (input pullup).
 * PB11 - PIN11                     (alternate 11).
 * PB12 - PIN12                     (alternate 11).
 * PB13 - PIN13                     (alternate 11).
 * PB14 - PIN14                     (input pullup).
 * PB15 - PIN15                     (input pullup).
 */
#define VAL_GPIOB_MODER             (PIN_MODE_ANALOG(GPIOB_PIN0) |           \
                                     PIN_MODE_ANALOG(GPIOB_PIN1) |           \
                                     PIN_MODE_INPUT(GPIOB_PIN2) |           \
                                     PIN_MODE_INPUT(GPIOB_SWO) |        \
                                     PIN_MODE_INPUT(GPIOB_PIN4) |           \
                                     PIN_MODE_INPUT(GPIOB_PIN5) |           \
                                     PIN_MODE_INPUT(GPIOB_PIN6_USART1_TX) |        \
                                     PIN_MODE_INPUT(GPIOB_PIN7_USART1_RX) |           \
                                     PIN_MODE_INPUT(GPIOB_PIN8) |           \
                                     PIN_MODE_INPUT(GPIOB_SDA) |        \
                                     PIN_MODE_INPUT(GPIOB_CLK_IN) |         \
                                     PIN_MODE_INPUT(GPIOB_PIN11_ETH_TX_EN) |          \
                                     PIN_MODE_ALTERNATE(GPIOB_PIN12_CAN2_RX) |          \
                                     PIN_MODE_OUTPUT(GPIOB_PIN13_LED_R) |          \
                                     PIN_MODE_OUTPUT(GPIOB_PIN14_LED_B) |          \
                                     PIN_MODE_OUTPUT(GPIOB_PIN15_LED_G))
#define VAL_GPIOB_OTYPER            (PIN_OTYPE_PUSHPULL(GPIOB_PIN0) |       \
                                     PIN_OTYPE_PUSHPULL(GPIOB_PIN1) |       \
                                     PIN_OTYPE_PUSHPULL(GPIOB_PIN2) |       \
                                     PIN_OTYPE_PUSHPULL(GPIOB_SWO) |        \
                                     PIN_OTYPE_PUSHPULL(GPIOB_PIN4) |       \
                                     PIN_OTYPE_PUSHPULL(GPIOB_PIN5) |       \
                                     PIN_OTYPE_PUSHPULL(GPIOB_PIN6_USART1_TX) |       \
                                     PIN_OTYPE_PUSHPULL(GPIOB_PIN7_USART1_RX) |       \
                                     PIN_OTYPE_PUSHPULL(GPIOB_PIN8) |       \
                                     PIN_OTYPE_OPENDRAIN(GPIOB_SDA) |       \
                                     PIN_OTYPE_PUSHPULL(GPIOB_CLK_IN) |     \
                                     PIN_OTYPE_PUSHPULL(GPIOB_PIN11_ETH_TX_EN) |      \
                                     PIN_OTYPE_PUSHPULL(GPIOB_PIN12_CAN2_RX) |      \
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
                                     PIN_AFIO_AF(GPIOB_PIN1, 0) |           \
                                     PIN_AFIO_AF(GPIOB_PIN2, 0) |           \
                                     PIN_AFIO_AF(GPIOB_SWO, 0) |            \
                                     PIN_AFIO_AF(GPIOB_PIN4, 0) |           \
                                     PIN_AFIO_AF(GPIOB_PIN5, 0) |           \
                                     PIN_AFIO_AF(GPIOB_PIN6_USART1_TX, 7) |            \
                                     PIN_AFIO_AF(GPIOB_PIN7_USART1_RX, 7))
#define VAL_GPIOB_AFRH              (PIN_AFIO_AF(GPIOB_PIN8, 0) |           \
                                     PIN_AFIO_AF(GPIOB_SDA, 4) |            \
                                     PIN_AFIO_AF(GPIOB_CLK_IN, 0) |         \
                                     PIN_AFIO_AF(GPIOB_PIN11_ETH_TX_EN, 11) |          \
                                     PIN_AFIO_AF(GPIOB_PIN12_CAN2_RX, 9) |          \
                                     PIN_AFIO_AF(GPIOB_PIN13_LED_R, 9) |          \
                                     PIN_AFIO_AF(GPIOB_PIN14_LED_B, 0) |          \
                                     PIN_AFIO_AF(GPIOB_PIN15_LED_G, 0))

/*
 * GPIOC setup:
 *
 * PC0  - OTG_FS_POWER_ON           (output pushpull maximum).
 * PC1  - PIN1                      (alternate 11).
 * PC2  - PIN2                      (input pullup).
 * PC3  - PDM_OUT                   (input pullup).
 * PC4  - PIN4                      (alternate 11).
 * PC5  - PIN5                      (alternate 11).
 * PC6  - PIN6                      (input pullup).
 * PC7  - MCLK                      (alternate 6).
 * PC8  - PIN8                      (input pullup).
 * PC9  - PIN9                      (input pullup).
 * PC10 - PIN10                     (alternate 7). UART3 TX
 * PC11 - PIN11                     (alternate 7). UART3 RX
 * PC12 - SDIN                      (input pullup)
 * PC13 - PIN13                     (input pullup).
 * PC14 - PIN14                     (input pullup).
 * PC15 - PIN15                     (input pullup).
 */
#define VAL_GPIOC_MODER             (PIN_MODE_INPUT(GPIOC_OTG_FS_POWER_ON) |\
                                     PIN_MODE_INPUT(GPIOC_PIN1_MDC) |           \
                                     PIN_MODE_INPUT(GPIOC_PIN2) |           \
                                     PIN_MODE_INPUT(GPIOC_PDM_OUT) |        \
                                     PIN_MODE_ANALOG(GPIOC_PIN4) |           \
                                     PIN_MODE_ANALOG(GPIOC_PIN5) |           \
                                     PIN_MODE_INPUT(GPIOC_PIN6_BTN) |           \
                                     PIN_MODE_ALTERNATE(GPIOC_PIN7_USART6_RX) |       \
                                     PIN_MODE_ALTERNATE(GPIOC_PIN8_SDIO_DAT0) |           \
                                     PIN_MODE_ALTERNATE(GPIOC_PIN9_SDIO_DAT1) |           \
                                     PIN_MODE_ALTERNATE(GPIOC_PIN10_SDIO_DAT2) |       \
                                     PIN_MODE_ALTERNATE(GPIOC_PIN11_SDIO_DAT3) |          \
                                     PIN_MODE_ALTERNATE(GPIOC_PIN12_SDIO_CLK) |       \
                                     PIN_MODE_INPUT(GPIOC_PIN13) |          \
                                     PIN_MODE_INPUT(GPIOC_PIN14) |          \
                                     PIN_MODE_INPUT(GPIOC_PIN15))
#define VAL_GPIOC_OTYPER            (PIN_OTYPE_PUSHPULL(GPIOC_OTG_FS_POWER_ON) |\
                                     PIN_OTYPE_PUSHPULL(GPIOC_PIN1_MDC) |       \
                                     PIN_OTYPE_PUSHPULL(GPIOC_PIN2) |       \
                                     PIN_OTYPE_PUSHPULL(GPIOC_PDM_OUT) |    \
                                     PIN_OTYPE_PUSHPULL(GPIOC_PIN4) |       \
                                     PIN_OTYPE_PUSHPULL(GPIOC_PIN5) |       \
                                     PIN_OTYPE_PUSHPULL(GPIOC_PIN6_BTN) |       \
                                     PIN_OTYPE_PUSHPULL(GPIOC_PIN7_USART6_RX) |       \
                                     PIN_OTYPE_PUSHPULL(GPIOC_PIN8_SDIO_DAT0) |       \
                                     PIN_OTYPE_PUSHPULL(GPIOC_PIN9_SDIO_DAT1) |       \
                                     PIN_OTYPE_PUSHPULL(GPIOC_PIN10_SDIO_DAT2) |       \
                                     PIN_OTYPE_PUSHPULL(GPIOC_PIN11_SDIO_DAT3) |      \
                                     PIN_OTYPE_PUSHPULL(GPIOC_PIN12_SDIO_CLK) |       \
                                     PIN_OTYPE_PUSHPULL(GPIOC_PIN13) |      \
                                     PIN_OTYPE_PUSHPULL(GPIOC_PIN14) |      \
                                     PIN_OTYPE_PUSHPULL(GPIOC_PIN15))
#define VAL_GPIOC_OSPEEDR   0xFFFFFFFF
#define VAL_GPIOC_PUPDR             (PIN_PUPDR_FLOATING(GPIOC_OTG_FS_POWER_ON) |\
                                     PIN_PUPDR_PULLUP(GPIOC_PIN2) |         \
                                     PIN_PUPDR_PULLUP(GPIOC_PDM_OUT) |      \
                                     PIN_PUPDR_PULLDOWN(GPIOC_PIN6_BTN) |         \
                                     PIN_PUPDR_FLOATING(GPIOC_PIN7_USART6_RX) |       \
                                     PIN_PUPDR_PULLUP(GPIOC_PIN8_SDIO_DAT0) |         \
                                     PIN_PUPDR_PULLUP(GPIOC_PIN9_SDIO_DAT1) |         \
                                     PIN_PUPDR_PULLUP(GPIOC_PIN10_SDIO_DAT2) |       \
                                     PIN_PUPDR_PULLUP(GPIOC_PIN11_SDIO_DAT3) |        \
                                     PIN_PUPDR_PULLUP(GPIOC_PIN12_SDIO_CLK) |       \
                                     PIN_PUPDR_PULLUP(GPIOC_PIN13) |        \
                                     PIN_PUPDR_PULLUP(GPIOC_PIN14) |        \
                                     PIN_PUPDR_PULLUP(GPIOC_PIN15))
#define VAL_GPIOC_ODR               (PIN_ODR_HIGH(GPIOC_OTG_FS_POWER_ON) |  \
                                     PIN_ODR_HIGH(GPIOC_PIN1_MDC) |             \
                                     PIN_ODR_HIGH(GPIOC_PIN2) |             \
                                     PIN_ODR_HIGH(GPIOC_PDM_OUT) |          \
                                     PIN_ODR_HIGH(GPIOC_PIN4) |             \
                                     PIN_ODR_HIGH(GPIOC_PIN5) |             \
                                     PIN_ODR_HIGH(GPIOC_PIN6_BTN) |             \
                                     PIN_ODR_HIGH(GPIOC_PIN7_USART6_RX) |             \
                                     PIN_ODR_HIGH(GPIOC_PIN8_SDIO_DAT0) |             \
                                     PIN_ODR_HIGH(GPIOC_PIN9_SDIO_DAT1) |             \
                                     PIN_ODR_HIGH(GPIOC_PIN10_SDIO_DAT2) |             \
                                     PIN_ODR_HIGH(GPIOC_PIN11_SDIO_DAT3) |            \
                                     PIN_ODR_HIGH(GPIOC_PIN12_SDIO_CLK) |             \
                                     PIN_ODR_HIGH(GPIOC_PIN13) |            \
                                     PIN_ODR_HIGH(GPIOC_PIN14) |            \
                                     PIN_ODR_HIGH(GPIOC_PIN15))
#define VAL_GPIOC_AFRL              (PIN_AFIO_AF(GPIOC_OTG_FS_POWER_ON, 0) |\
                                     PIN_AFIO_AF(GPIOC_PIN1_MDC, 11) |           \
                                     PIN_AFIO_AF(GPIOC_PIN2, 0) |           \
                                     PIN_AFIO_AF(GPIOC_PDM_OUT, 0) |        \
                                     PIN_AFIO_AF(GPIOC_PIN4, 11) |           \
                                     PIN_AFIO_AF(GPIOC_PIN5, 11) |           \
                                     PIN_AFIO_AF(GPIOC_PIN6_BTN, 8) |           \
                                     PIN_AFIO_AF(GPIOC_PIN7_USART6_RX, 8))
#define VAL_GPIOC_AFRH              (PIN_AFIO_AF(GPIOC_PIN8_SDIO_DAT0, 12) |           \
                                     PIN_AFIO_AF(GPIOC_PIN9_SDIO_DAT1, 12) |           \
                                     PIN_AFIO_AF(GPIOC_PIN10_SDIO_DAT2, 12) |           \
                                     PIN_AFIO_AF(GPIOC_PIN11_SDIO_DAT3, 12) |          \
                                     PIN_AFIO_AF(GPIOC_PIN12_SDIO_CLK, 12) |           \
                                     PIN_AFIO_AF(GPIOC_PIN13, 0) |          \
                                     PIN_AFIO_AF(GPIOC_PIN14, 0) |          \
                                     PIN_AFIO_AF(GPIOC_PIN15, 0))

/*
 * GPIOD setup:
 *
 * PD0  - PIN0                      (input pullup).
 * PD1  - PIN1                      (input pullup).
 * PD2  - PIN2                      (input pullup).
 * PD3  - PIN3                      (input pullup).
 * PD4  - RESET                     (output pushpull maximum).
 * PD5  - OVER_CURRENT              (input floating).
 * PD6  - PIN6                      (input pullup).
 * PD7  - PIN7                      (input pullup).
 * PD8  - PIN8                      (input pullup).
 * PD9  - PIN9                      (input pullup).
 * PD10 - PIN10                     (input pullup).
 * PD11 - PIN11                     (input floating).
 * PD12 - LED4                      (output pushpull maximum).
 * PD13 - LED3                      (output pushpull maximum).
 * PD14 - LED5                      (output pushpull maximum).
 * PD15 - LED6                      (output pushpull maximum).
 */
#define VAL_GPIOD_MODER             (PIN_MODE_INPUT(GPIOD_PIN0) |           \
                                     PIN_MODE_INPUT(GPIOD_PIN1) |           \
                                     PIN_MODE_ALTERNATE(GPIOD_PIN2_SDIO_CMD) |           \
                                     PIN_MODE_INPUT(GPIOD_PIN3) |           \
                                     PIN_MODE_INPUT(GPIOD_RESET) |         \
                                     PIN_MODE_INPUT(GPIOD_PIN5_USART2_TX) |   \
                                     PIN_MODE_INPUT(GPIOD_PIN6_USART2_RX) |           \
                                     PIN_MODE_INPUT(GPIOD_PIN7) |           \
                                     PIN_MODE_INPUT(GPIOD_PIN8) |           \
                                     PIN_MODE_INPUT(GPIOD_PIN9_USART3_RX) |           \
                                     PIN_MODE_INPUT(GPIOD_PIN10) |          \
                                     PIN_MODE_INPUT(GPIOD_PIN11) |          \
                                     PIN_MODE_INPUT(GPIOD_PIN12) |          \
                                     PIN_MODE_INPUT(GPIOD_PIN13) |          \
                                     PIN_MODE_INPUT(GPIOD_PIN14) |          \
                                     PIN_MODE_INPUT(GPIOD_PIN15))
#define VAL_GPIOD_OTYPER            (PIN_OTYPE_PUSHPULL(GPIOD_PIN0) |       \
                                     PIN_OTYPE_PUSHPULL(GPIOD_PIN1) |       \
                                     PIN_OTYPE_PUSHPULL(GPIOD_PIN2_SDIO_CMD) |       \
                                     PIN_OTYPE_PUSHPULL(GPIOD_PIN3) |       \
                                     PIN_OTYPE_PUSHPULL(GPIOD_RESET) |      \
                                     PIN_OTYPE_PUSHPULL(GPIOD_PIN5_USART2_TX) |\
                                     PIN_OTYPE_PUSHPULL(GPIOD_PIN6_USART2_RX) |       \
                                     PIN_OTYPE_PUSHPULL(GPIOD_PIN7) |       \
                                     PIN_OTYPE_PUSHPULL(GPIOD_PIN8) |       \
                                     PIN_OTYPE_PUSHPULL(GPIOD_PIN9_USART3_RX) |       \
                                     PIN_OTYPE_PUSHPULL(GPIOD_PIN10) |      \
                                     PIN_OTYPE_PUSHPULL(GPIOD_PIN11) |      \
                                     PIN_OTYPE_PUSHPULL(GPIOD_PIN12) |       \
                                     PIN_OTYPE_PUSHPULL(GPIOD_PIN13) |       \
                                     PIN_OTYPE_PUSHPULL(GPIOD_PIN14) |       \
                                     PIN_OTYPE_PUSHPULL(GPIOD_PIN15))
#define VAL_GPIOD_OSPEEDR           (PIN_OSPEED_100M(GPIOD_PIN0) |          \
                                     PIN_OSPEED_100M(GPIOD_PIN1) |          \
                                     PIN_OSPEED_100M(GPIOD_PIN2_SDIO_CMD) |          \
                                     PIN_OSPEED_100M(GPIOD_PIN3) |          \
                                     PIN_OSPEED_100M(GPIOD_RESET) |         \
                                     PIN_OSPEED_100M(GPIOD_PIN5_USART2_TX) |  \
                                     PIN_OSPEED_100M(GPIOD_PIN6_USART2_RX) |          \
                                     PIN_OSPEED_100M(GPIOD_PIN7) |          \
                                     PIN_OSPEED_100M(GPIOD_PIN8) |          \
                                     PIN_OSPEED_100M(GPIOD_PIN9_USART3_RX) |          \
                                     PIN_OSPEED_100M(GPIOD_PIN10) |         \
                                     PIN_OSPEED_100M(GPIOD_PIN11) |         \
                                     PIN_OSPEED_100M(GPIOD_PIN12) |          \
                                     PIN_OSPEED_100M(GPIOD_PIN13) |          \
                                     PIN_OSPEED_100M(GPIOD_PIN14) |          \
                                     PIN_OSPEED_100M(GPIOD_PIN15))
#define VAL_GPIOD_PUPDR             (PIN_PUPDR_PULLUP(GPIOD_PIN0) |         \
                                     PIN_PUPDR_PULLUP(GPIOD_PIN1) |         \
                                     PIN_PUPDR_PULLUP(GPIOD_PIN2_SDIO_CMD) |         \
                                     PIN_PUPDR_PULLUP(GPIOD_PIN3) |         \
                                     PIN_PUPDR_FLOATING(GPIOD_RESET) |      \
                                     PIN_PUPDR_FLOATING(GPIOD_PIN5_USART2_TX) |\
                                     PIN_PUPDR_PULLUP(GPIOD_PIN6_USART2_RX) |         \
                                     PIN_PUPDR_PULLUP(GPIOD_PIN7) |         \
                                     PIN_PUPDR_PULLUP(GPIOD_PIN8) |         \
                                     PIN_PUPDR_PULLUP(GPIOD_PIN9_USART3_RX) |         \
                                     PIN_PUPDR_PULLUP(GPIOD_PIN10) |        \
                                     PIN_PUPDR_FLOATING(GPIOD_PIN11) |      \
                                     PIN_PUPDR_FLOATING(GPIOD_PIN12) |       \
                                     PIN_PUPDR_FLOATING(GPIOD_PIN13) |       \
                                     PIN_PUPDR_FLOATING(GPIOD_PIN14) |       \
                                     PIN_PUPDR_FLOATING(GPIOD_PIN15))
#define VAL_GPIOD_ODR               (PIN_ODR_HIGH(GPIOD_PIN0) |             \
                                     PIN_ODR_HIGH(GPIOD_PIN1) |             \
                                     PIN_ODR_HIGH(GPIOD_PIN2_SDIO_CMD) |             \
                                     PIN_ODR_HIGH(GPIOD_PIN3) |             \
                                     PIN_ODR_HIGH(GPIOD_RESET) |            \
                                     PIN_ODR_HIGH(GPIOD_PIN5_USART2_TX) |     \
                                     PIN_ODR_HIGH(GPIOD_PIN6_USART2_RX) |             \
                                     PIN_ODR_HIGH(GPIOD_PIN7) |             \
                                     PIN_ODR_HIGH(GPIOD_PIN8) |             \
                                     PIN_ODR_HIGH(GPIOD_PIN9_USART3_RX) |             \
                                     PIN_ODR_HIGH(GPIOD_PIN10) |            \
                                     PIN_ODR_HIGH(GPIOD_PIN11) |            \
                                     PIN_ODR_LOW(GPIOD_PIN12) |              \
                                     PIN_ODR_LOW(GPIOD_PIN13) |              \
                                     PIN_ODR_LOW(GPIOD_PIN14) |              \
                                     PIN_ODR_LOW(GPIOD_PIN15))
#define VAL_GPIOD_AFRL              (PIN_AFIO_AF(GPIOD_PIN0, 0) |           \
                                     PIN_AFIO_AF(GPIOD_PIN1, 0) |           \
                                     PIN_AFIO_AF(GPIOD_PIN2_SDIO_CMD, 12) |           \
                                     PIN_AFIO_AF(GPIOD_PIN3, 0) |           \
                                     PIN_AFIO_AF(GPIOD_RESET, 0) |          \
                                     PIN_AFIO_AF(GPIOD_PIN5_USART2_TX, 7) |   \
                                     PIN_AFIO_AF(GPIOD_PIN6_USART2_RX, 7) |           \
                                     PIN_AFIO_AF(GPIOD_PIN7, 0))
#define VAL_GPIOD_AFRH              (PIN_AFIO_AF(GPIOD_PIN8, 0) |           \
                                     PIN_AFIO_AF(GPIOD_PIN9_USART3_RX, 7) |           \
                                     PIN_AFIO_AF(GPIOD_PIN10, 0) |          \
                                     PIN_AFIO_AF(GPIOD_PIN11, 0) |          \
                                     PIN_AFIO_AF(GPIOD_PIN12, 0) |           \
                                     PIN_AFIO_AF(GPIOD_PIN13, 0) |           \
                                     PIN_AFIO_AF(GPIOD_PIN14, 0) |           \
                                     PIN_AFIO_AF(GPIOD_PIN15, 0))

/*
 * GPIOE setup:
 *
 * PE0  - INT1                      (input floating).
 * PE1  - INT2                      (input floating).
 * PE2  - PIN2                      (input floating).
 * PE3  - CS_SPI                    (output pushpull maximum).
 * PE4  - PIN4                      (input floating).
 * PE5  - PIN5                      (input floating).
 * PE6  - PIN6                      (input floating).
 * PE7  - PIN7                      (input floating).
 * PE8  - PIN8                      (input floating).
 * PE9  - PIN9                      (input floating).
 * PE10 - PIN10                     (input floating).
 * PE11 - PIN11                     (input floating).
 * PE12 - PIN12                     (input floating).
 * PE13 - PIN13                     (input floating).
 * PE14 - PIN14                     (input floating).
 * PE15 - PIN15                     (input floating).
 */
#define VAL_GPIOE_MODER             (PIN_MODE_INPUT(GPIOE_INT1) |           \
                                     PIN_MODE_INPUT(GPIOE_INT2) |           \
                                     PIN_MODE_INPUT(GPIOE_PIN2) |           \
                                     PIN_MODE_INPUT(GPIOE_CS_SPI) |        \
                                     PIN_MODE_INPUT(GPIOE_PIN4) |           \
                                     PIN_MODE_INPUT(GPIOE_PIN5) |           \
                                     PIN_MODE_INPUT(GPIOE_PIN6) |           \
                                     PIN_MODE_INPUT(GPIOE_PIN7) |           \
                                     PIN_MODE_INPUT(GPIOE_PIN8) |           \
                                     PIN_MODE_INPUT(GPIOE_PIN9) |           \
                                     PIN_MODE_INPUT(GPIOE_PIN10) |          \
                                     PIN_MODE_INPUT(GPIOE_PIN11) |          \
                                     PIN_MODE_INPUT(GPIOE_PIN12) |          \
                                     PIN_MODE_INPUT(GPIOE_PIN13) |          \
                                     PIN_MODE_INPUT(GPIOE_PIN14) |          \
                                     PIN_MODE_INPUT(GPIOE_PIN15))
#define VAL_GPIOE_OTYPER            (PIN_OTYPE_PUSHPULL(GPIOE_INT1) |       \
                                     PIN_OTYPE_PUSHPULL(GPIOE_INT2) |       \
                                     PIN_OTYPE_PUSHPULL(GPIOE_PIN2) |       \
                                     PIN_OTYPE_PUSHPULL(GPIOE_CS_SPI) |     \
                                     PIN_OTYPE_PUSHPULL(GPIOE_PIN4) |       \
                                     PIN_OTYPE_PUSHPULL(GPIOE_PIN5) |       \
                                     PIN_OTYPE_PUSHPULL(GPIOE_PIN6) |       \
                                     PIN_OTYPE_PUSHPULL(GPIOE_PIN7) |       \
                                     PIN_OTYPE_PUSHPULL(GPIOE_PIN8) |       \
                                     PIN_OTYPE_PUSHPULL(GPIOE_PIN9) |       \
                                     PIN_OTYPE_PUSHPULL(GPIOE_PIN10) |      \
                                     PIN_OTYPE_PUSHPULL(GPIOE_PIN11) |      \
                                     PIN_OTYPE_PUSHPULL(GPIOE_PIN12) |      \
                                     PIN_OTYPE_PUSHPULL(GPIOE_PIN13) |      \
                                     PIN_OTYPE_PUSHPULL(GPIOE_PIN14) |      \
                                     PIN_OTYPE_PUSHPULL(GPIOE_PIN15))
#define VAL_GPIOE_OSPEEDR           (PIN_OSPEED_100M(GPIOE_INT1) |          \
                                     PIN_OSPEED_100M(GPIOE_INT2) |          \
                                     PIN_OSPEED_100M(GPIOE_PIN2) |          \
                                     PIN_OSPEED_100M(GPIOE_CS_SPI) |        \
                                     PIN_OSPEED_100M(GPIOE_PIN4) |          \
                                     PIN_OSPEED_100M(GPIOE_PIN5) |          \
                                     PIN_OSPEED_100M(GPIOE_PIN6) |          \
                                     PIN_OSPEED_100M(GPIOE_PIN7) |          \
                                     PIN_OSPEED_100M(GPIOE_PIN8) |          \
                                     PIN_OSPEED_100M(GPIOE_PIN9) |          \
                                     PIN_OSPEED_100M(GPIOE_PIN10) |         \
                                     PIN_OSPEED_100M(GPIOE_PIN11) |         \
                                     PIN_OSPEED_100M(GPIOE_PIN12) |         \
                                     PIN_OSPEED_100M(GPIOE_PIN13) |         \
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
                                     PIN_AFIO_AF(GPIOG_PIN13, 0) |          \
                                     PIN_AFIO_AF(GPIOG_PIN14, 0) |          \
                                     PIN_AFIO_AF(GPIOG_PIN15, 0))

/*
 * GPIOH setup:
 *
 * PH0  - OSC_IN                    (input floating).
 * PH1  - OSC_OUT                   (input floating).
 * PH2  - PIN2                      (input floating).
 * PH3  - PIN3                      (input floating).
 * PH4  - PIN4                      (input floating).
 * PH5  - PIN5                      (input floating).
 * PH6  - PIN6                      (input floating).
 * PH7  - PIN7                      (input floating).
 * PH8  - PIN8                      (input floating).
 * PH9  - PIN9                      (input floating).
 * PH10 - PIN10                     (input floating).
 * PH11 - PIN11                     (input floating).
 * PH12 - PIN12                     (input floating).
 * PH13 - PIN13                     (input floating).
 * PH14 - PIN14                     (input floating).
 * PH15 - PIN15                     (input floating).
 */
#define VAL_GPIOH_MODER             (PIN_MODE_INPUT(GPIOH_OSC_IN) |         \
                                     PIN_MODE_INPUT(GPIOH_OSC_OUT) |        \
                                     PIN_MODE_INPUT(GPIOH_PIN2) |           \
                                     PIN_MODE_INPUT(GPIOH_PIN3) |           \
                                     PIN_MODE_INPUT(GPIOH_PIN4) |           \
                                     PIN_MODE_INPUT(GPIOH_PIN5) |           \
                                     PIN_MODE_INPUT(GPIOH_PIN6) |           \
                                     PIN_MODE_INPUT(GPIOH_PIN7) |           \
                                     PIN_MODE_INPUT(GPIOH_PIN8) |           \
                                     PIN_MODE_INPUT(GPIOH_PIN9) |           \
                                     PIN_MODE_INPUT(GPIOH_PIN10) |          \
                                     PIN_MODE_INPUT(GPIOH_PIN11) |          \
                                     PIN_MODE_INPUT(GPIOH_PIN12) |          \
                                     PIN_MODE_INPUT(GPIOH_PIN13) |          \
                                     PIN_MODE_INPUT(GPIOH_PIN14) |          \
                                     PIN_MODE_INPUT(GPIOH_PIN15))
#define VAL_GPIOH_OTYPER            (PIN_OTYPE_PUSHPULL(GPIOH_OSC_IN) |     \
                                     PIN_OTYPE_PUSHPULL(GPIOH_OSC_OUT) |    \
                                     PIN_OTYPE_PUSHPULL(GPIOH_PIN2) |       \
                                     PIN_OTYPE_PUSHPULL(GPIOH_PIN3) |       \
                                     PIN_OTYPE_PUSHPULL(GPIOH_PIN4) |       \
                                     PIN_OTYPE_PUSHPULL(GPIOH_PIN5) |       \
                                     PIN_OTYPE_PUSHPULL(GPIOH_PIN6) |       \
                                     PIN_OTYPE_PUSHPULL(GPIOH_PIN7) |       \
                                     PIN_OTYPE_PUSHPULL(GPIOH_PIN8) |       \
                                     PIN_OTYPE_PUSHPULL(GPIOH_PIN9) |       \
                                     PIN_OTYPE_PUSHPULL(GPIOH_PIN10) |      \
                                     PIN_OTYPE_PUSHPULL(GPIOH_PIN11) |      \
                                     PIN_OTYPE_PUSHPULL(GPIOH_PIN12) |      \
                                     PIN_OTYPE_PUSHPULL(GPIOH_PIN13) |      \
                                     PIN_OTYPE_PUSHPULL(GPIOH_PIN14) |      \
                                     PIN_OTYPE_PUSHPULL(GPIOH_PIN15))
#define VAL_GPIOH_OSPEEDR           (PIN_OSPEED_100M(GPIOH_OSC_IN) |        \
                                     PIN_OSPEED_100M(GPIOH_OSC_OUT) |       \
                                     PIN_OSPEED_100M(GPIOH_PIN2) |          \
                                     PIN_OSPEED_100M(GPIOH_PIN3) |          \
                                     PIN_OSPEED_100M(GPIOH_PIN4) |          \
                                     PIN_OSPEED_100M(GPIOH_PIN5) |          \
                                     PIN_OSPEED_100M(GPIOH_PIN6) |          \
                                     PIN_OSPEED_100M(GPIOH_PIN7) |          \
                                     PIN_OSPEED_100M(GPIOH_PIN8) |          \
                                     PIN_OSPEED_100M(GPIOH_PIN9) |          \
                                     PIN_OSPEED_100M(GPIOH_PIN10) |         \
                                     PIN_OSPEED_100M(GPIOH_PIN11) |         \
                                     PIN_OSPEED_100M(GPIOH_PIN12) |         \
                                     PIN_OSPEED_100M(GPIOH_PIN13) |         \
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
                                     PIN_PUPDR_FLOATING(GPIOI_PIN14) |      \
                                     PIN_PUPDR_FLOATING(GPIOI_PIN15))
#define VAL_GPIOI_ODR               (PIN_ODR_HIGH(GPIOI_PIN0) |             \
                                     PIN_ODR_HIGH(GPIOI_PIN1) |             \
                                     PIN_ODR_HIGH(GPIOI_PIN2) |             \
                                     PIN_ODR_HIGH(GPIOI_PIN3) |             \
                                     PIN_ODR_HIGH(GPIOI_PIN4) |             \
                                     PIN_ODR_HIGH(GPIOI_PIN5) |             \
                                     PIN_ODR_HIGH(GPIOI_PIN6) |             \
                                     PIN_ODR_HIGH(GPIOI_PIN7) |             \
                                     PIN_ODR_HIGH(GPIOI_PIN8) |             \
                                     PIN_ODR_HIGH(GPIOI_PIN9) |             \
                                     PIN_ODR_HIGH(GPIOI_PIN10) |            \
                                     PIN_ODR_HIGH(GPIOI_PIN11) |            \
                                     PIN_ODR_HIGH(GPIOI_PIN12) |            \
                                     PIN_ODR_HIGH(GPIOI_PIN13) |            \
                                     PIN_ODR_HIGH(GPIOI_PIN14) |            \
                                     PIN_ODR_HIGH(GPIOI_PIN15))
#define VAL_GPIOI_AFRL              (PIN_AFIO_AF(GPIOI_PIN0, 0) |           \
                                     PIN_AFIO_AF(GPIOI_PIN1, 0) |           \
                                     PIN_AFIO_AF(GPIOI_PIN2, 0) |           \
                                     PIN_AFIO_AF(GPIOI_PIN3, 0) |           \
                                     PIN_AFIO_AF(GPIOI_PIN4, 0) |           \
                                     PIN_AFIO_AF(GPIOI_PIN5, 0) |           \
                                     PIN_AFIO_AF(GPIOI_PIN6, 0) |           \
                                     PIN_AFIO_AF(GPIOI_PIN7, 0))
#define VAL_GPIOI_AFRH              (PIN_AFIO_AF(GPIOI_PIN8, 0) |           \
                                     PIN_AFIO_AF(GPIOI_PIN9, 0) |           \
                                     PIN_AFIO_AF(GPIOI_PIN10, 0) |          \
                                     PIN_AFIO_AF(GPIOI_PIN11, 0) |          \
                                     PIN_AFIO_AF(GPIOI_PIN12, 0) |          \
                                     PIN_AFIO_AF(GPIOI_PIN13, 0) |          \
                                     PIN_AFIO_AF(GPIOI_PIN14, 0) |          \
                                     PIN_AFIO_AF(GPIOI_PIN15, 0))


#if !defined(_FROM_ASM_)
#ifdef __cplusplus
extern "C" {
#endif
  void boardInit(void);
#ifdef __cplusplus
}
#endif
#endif /* _FROM_ASM_ */

#endif /* _BOARD_H_ */
