akpc806a/Voltage_Logger/(commit log)

2017-02-19 initial commit of stable firmware
    (tested: sample time, channel selection, calibraion, filtering)
2017-02-19 hardware files added
    [Voltage_Logger.brd, Voltage_Logger.sch]
2017-02-20 AC tests added
    [50Hz.csv, 50Hz.xls, 50Hz_sine.csv, 50Hz_sine.xls, 5Hz.csv, 5Hz.xls, 5Hz_sine.csv, 5Hz_sine.xls]
2017-02-22 filtering moved to ADC callback
2017-04-04 LEDs corrected
2017-04-07 channels remapped, documentation added, ready for tindie
    [Voltage_Logger.brd]
2017-04-07 test with thermocouple added (AD8495 amplifier)
    [Temperature.xlsx]
2017-04-07 temperature test updated
    [Temperature.xlsx]
