akpc806a/Voltage_Logger/(notices)

Notices in the files:
parts and their libraries:
resistor-array: Copyright (C) 2008, Bob Starr
microbuilder: This work is placed in the public domain, and may be freely used for commercial and non-commercial work with the following conditions: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
